iorodeo/i_control_led/README.md

# IO Rodeo i_control_led 

Hardware files for IO Rodeo's current controlled led designed to be used with
our [cuvette holder](https://github.com/iorodeo/cuvette_holder).

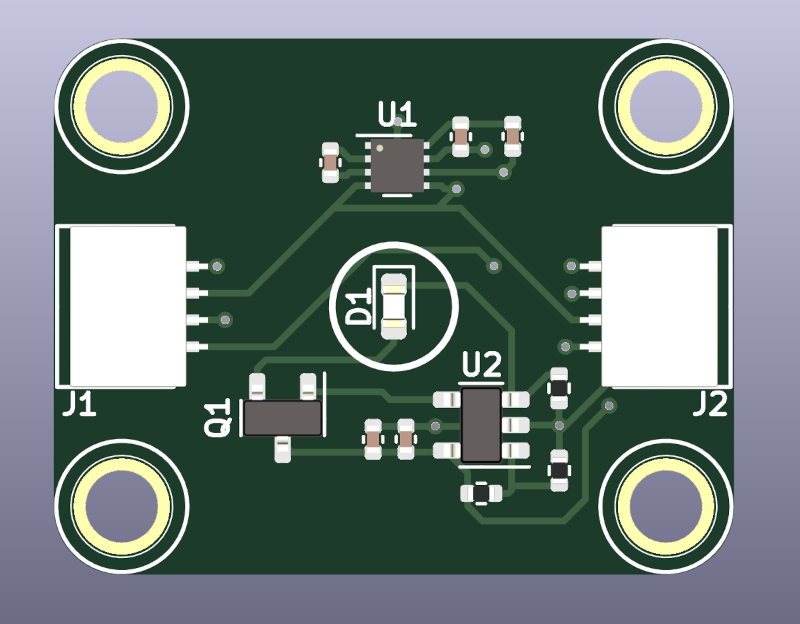
[picture p1: images/i_control_led.png]


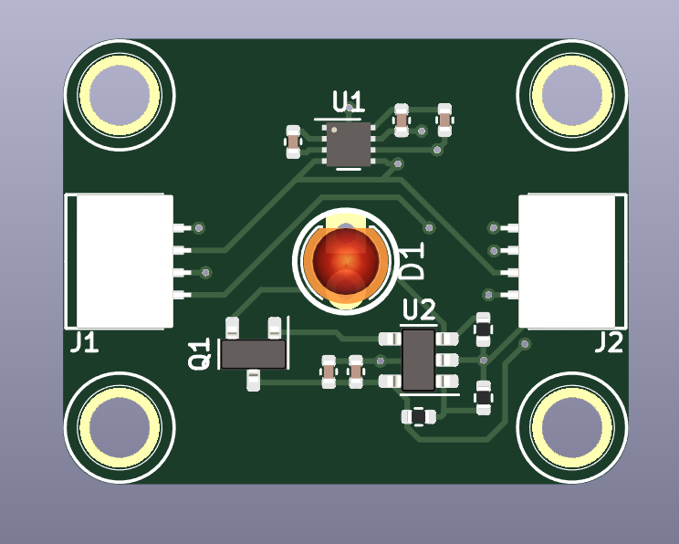
[picture p2: images/i_control_led_radial.png]
