iorodeo/i_control_led/fixed/radial/notes.txt

* Footprints for J1 and J2 (C145956) aren't quite right and had to be corrected
  by JLCPCB. Ask for exact footprint specs ... data sheet doesn't seem to
  specify it completely.
