iorodeo/i_control_led/fixed/10V_regulator/278nm_ELUC3535NUB_16mA/notes.txt

* missing trace between D1 and L1. 

* JLCPCB put LED on wrong way around.

* Footprints for J1 and J2 (C145956) aren't quite right and had to be corrected
  by JLCPCB. Ask for exact footprint specs ... data sheet doesn't seem to
  specify it completely.
