iorodeo/i_control_led/i2c/5V_regulator/SMD0603_i2c/production/ver_0p1_rev_2/BOM_JLCPCB_SMD0603_16mA.xlsx

Comment | Designator | Footprint | LCSC Part #（optional） | Qty
10V 10μF Ceramic Capacitor | C1,C2 C4 | 0402 | C315248 | 3
16V 100nF Ceramic Capacitor | C3 | 0402 | C1525 | 1
4-Pin Connector, JST SM04B-SRSS-TB | J1 ,J2 | SMD,P=1mm | C160404 | 2
4.7μH Inductor ±20%, 440mOhm | L1 | 0603 | C114862 | 1
MMBT5551LT1G Bipolar Transistor, 600mA NPN | Q1 | SOT-23 | C41095 | 1
10Ω ±1% Resistor | R1 | 0402 | C413044 | 1
30kΩ ±1% Resistor | R2 | 0402 | C138008 | 1
1kΩ ±1% Resistor | R3 | 0402 | C144789 | 1
TPS61222DCKR, boost converter, fixed 5V | U1 | SOT-363-6(SC-70-6) | C116461 | 1
LMV321 Operational Amplifier | U2 | SOT-23-5 | C7972 | 1
