iorodeo/i_control_led/fixed/10V_regulator/255nm_IN_C35PPCTGU0_16mA/production/ver_0p1_rev_1/BOM_JLCPCB_255nm_IN_C35PPCTGU0_16mA.xlsx

Comment | Designator | Footprint | LCSC Part #（optional） | Qty
1uF Ceramic Capacitor | C1,C2,C4 | 0402 | C29266 | 3
0.1uF Ceramic Capacitor | C3 | 0402 | C3012376 | 1
255nm UV LED | D1 | 1414 | Global Parts | 1
Schottky Barrier Diode | D2 | SOD-523 | C345957 | 1
4-Pin Connector, JST SM04B-SRSS-TB | J1 ,J2 | SMD,P=1mm | C145956 | 2
22uH Inductor | L1 | 0603 | C383393 | 1
MMBT5551LT1G Bipolar Transistor, 600mA NPN | Q1 | SOT-23 | C41095 | 1
10Ω ±1% Resistor | R1 | 0402 | C25077 | 1
24kΩ ±1% Resistor | R2 | 0402 | C138026 | 1
390Ω ±1% Resistor | R3 | 0402 | C137997 | 1
14kΩ ±1% Resistor | R4,R5 | 0402 | C3015834 | 2
2kΩ ±1% Resistor | R6 | 0402 | C60488 | 1
AP3012KTR-E1 boost converter | U1 | SOT-23-5 | C102618 | 1
AS321 Operational Amplifier | U2 | SOT-23-5 | C144156 | 1
