iorodeo/i_control_led/fixed/10V_regulator/255nm_IN_C35PPCTGU0_16mA/3dmodels/SM04B-SRSS.step

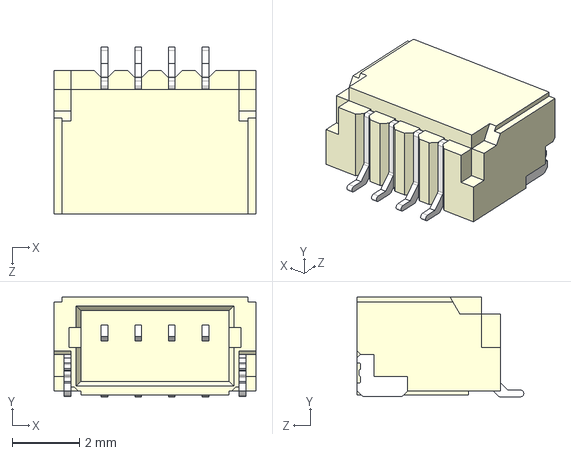
[picture p3: CAD file, 2023-11-25]
fixed/10V_regulator/255nm_IN_C35PPCTGU0_16mA/3dmodels/SM04B-SRSS.step
6.00 x 2.96 x 4.95 mm
