iorodeo/i_control_led/fixed/10V_regulator/255nm_IN_C35PPCTGU0_16mA/schematic_255nm_led_board.pdf

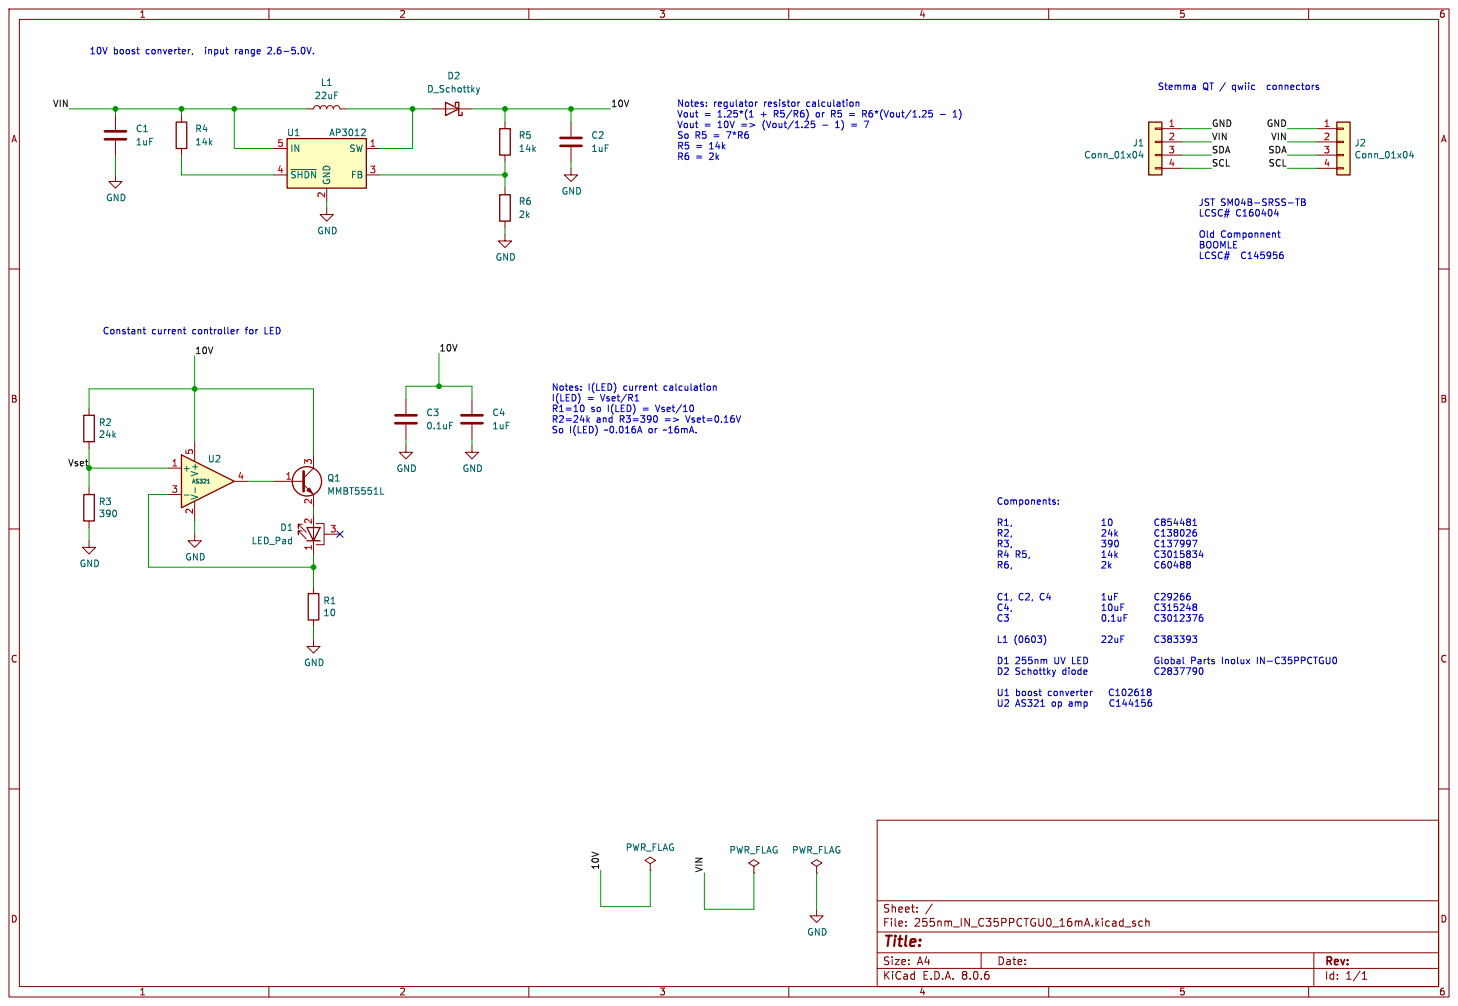
[picture p4: page 1]

JST SM04B-SRSS-TB
LCSC# C160404 Old Componnent BOOMLE

Notes: I(LED) current calculation

Id: 1/1 Title: File: 255nm_IN_C35PPCTGU0_16mA.kicad_sch Sheet: /
