iorodeo/i_control_led/fixed/5V_regulator/850nm_16mA/850nm_16mA.pdf

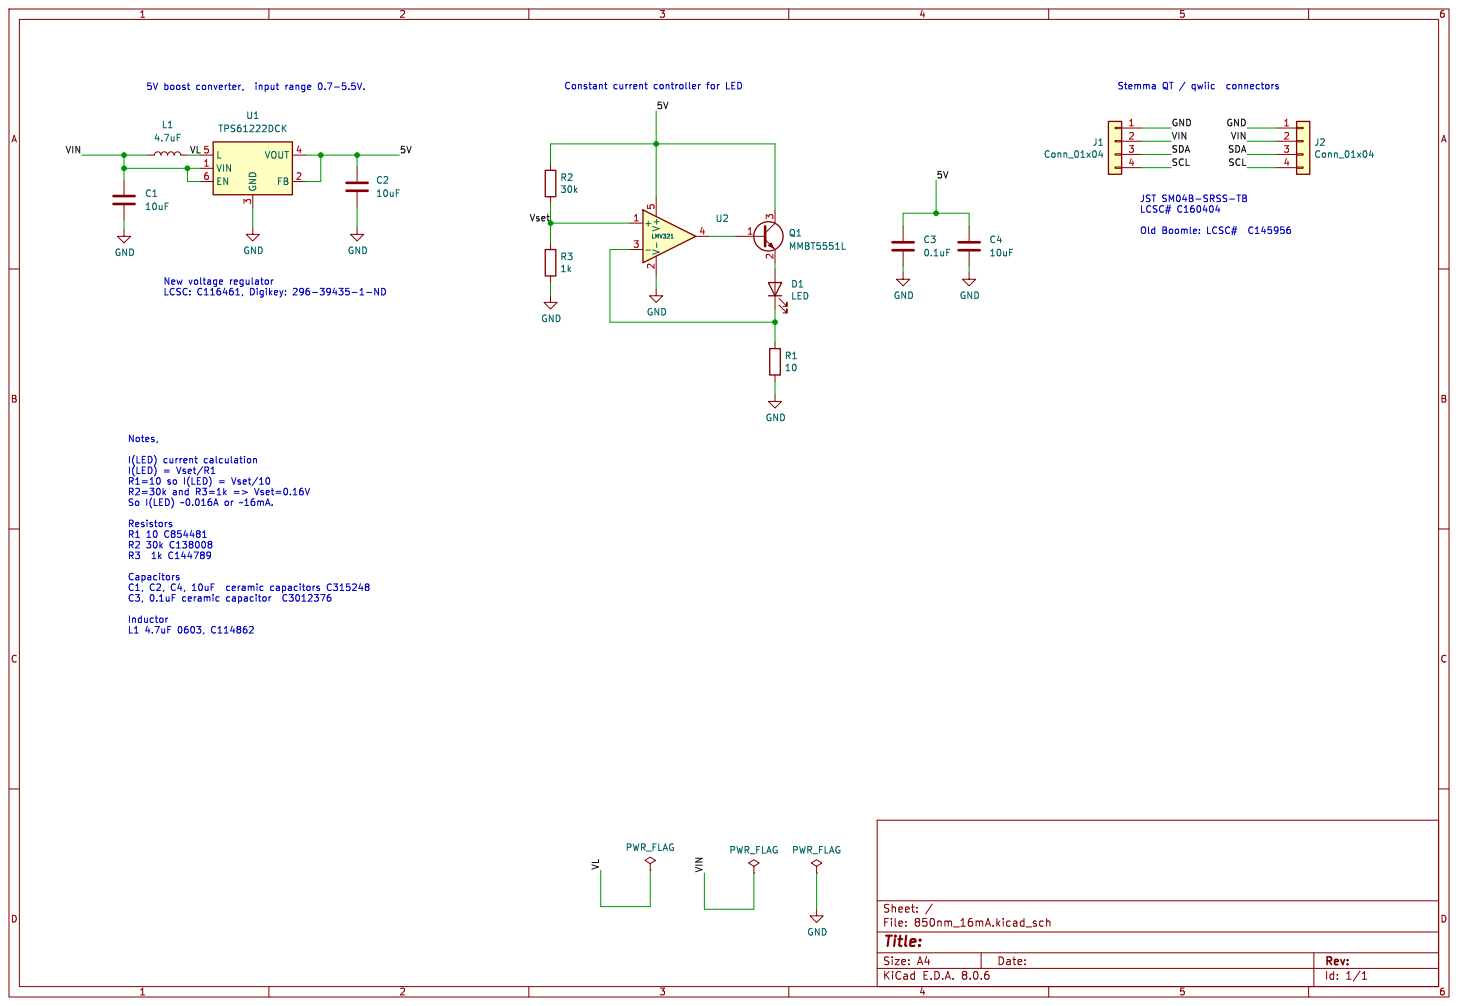
[picture p5: page 1]

Id: 1/1 Title: File: 850nm_16mA.kicad_sch Sheet: /
