iorodeo/i_control_led/fixed/5V_regulator/470nm_16mA/470nm_16mA.pdf

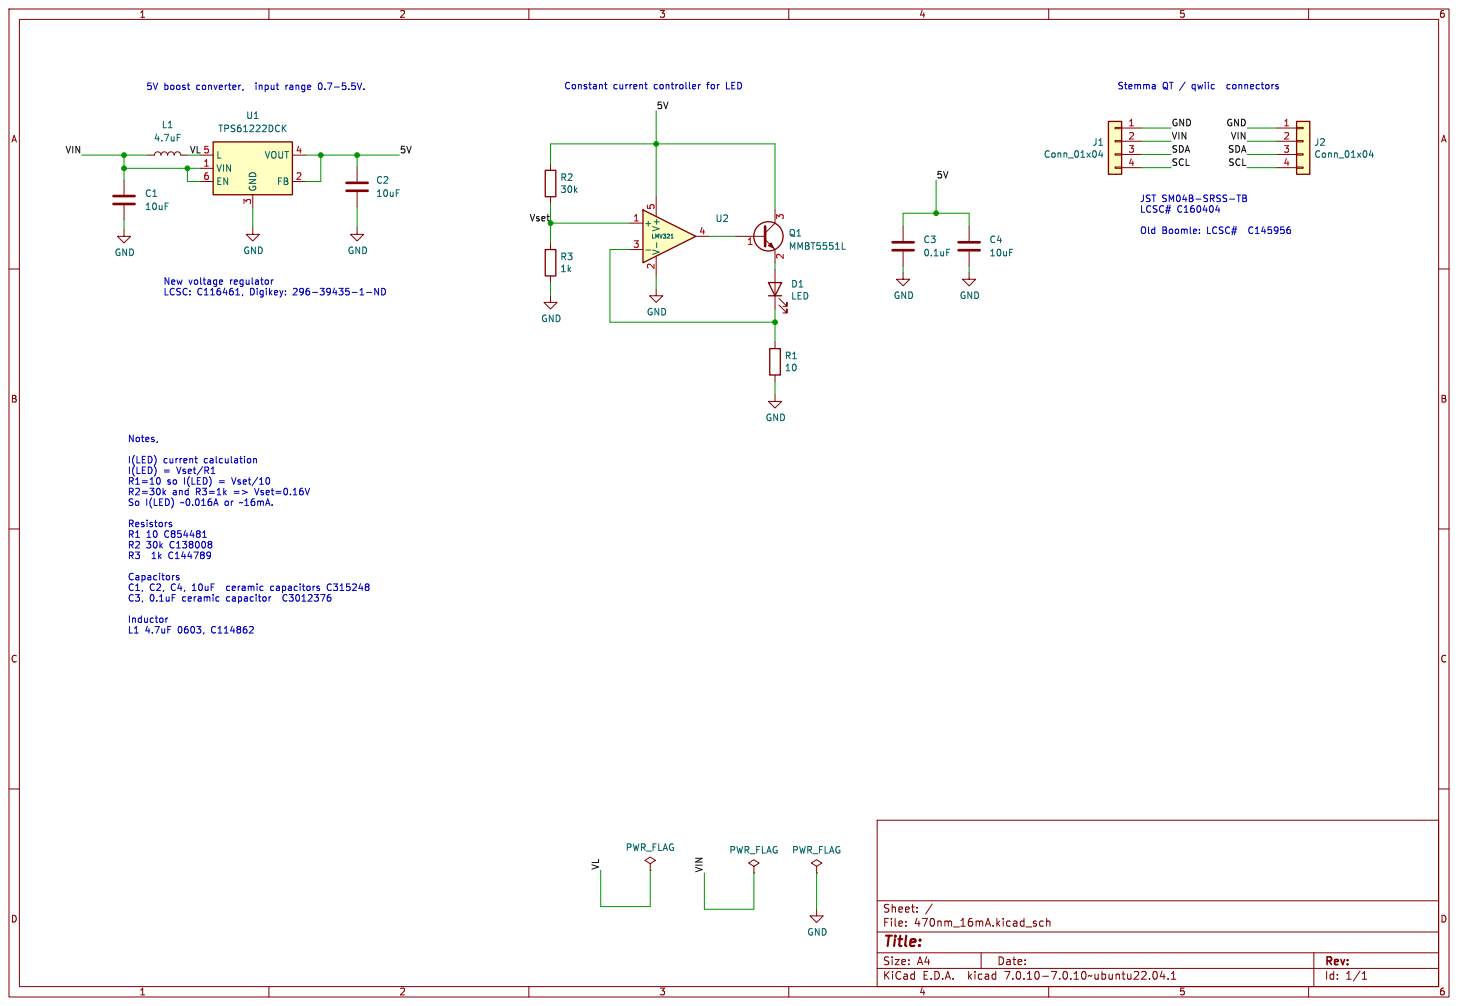
[picture p6: page 1]

Id: 1/1 Title: File: 470nm_16mA.kicad_sch Sheet: /
