iorodeo/i_control_led/(list of files, drawings)

Other design files:
fixed/5V_regulator/365nm_16mA/365nm_16mA.dsn
fixed/5V_regulator/385nm_16mA/385nm_16mA.dsn
fixed/5V_regulator/395nm_16mA/395nm_16mA.dsn
fixed/5V_regulator/415nm_16mA/415nm_16mA.dsn
fixed/5V_regulator/470nm_16mA/470nm_16mA.dsn
fixed/5V_regulator/496nm_16mA/496nm_16mA.dsn
fixed/5V_regulator/520nm_16mA/520nm_16mA.dsn
fixed/5V_regulator/557nm_16mA/557nm_16mA.dsn
fixed/5V_regulator/570nm_16mA/570nm_16mA.dsn
fixed/5V_regulator/595nm_16mA/595nm_16mA.dsn
fixed/5V_regulator/610nm_16mA/610nm_16mA.dsn
fixed/5V_regulator/630nm_16mA/630nm_16mA.dsn
fixed/5V_regulator/660nm_16mA/660nm_16mA.dsn
fixed/5V_regulator/850nm_16mA/850nm_16mA.dsn
fixed/5V_regulator/radial_16mA/radial_16mA.dsn
fixed/5V_regulator/radial_24mA/radial_24mA.dsn
fixed/5V_regulator/SMD0603_16mA/SMD0603_16mA.dsn
fixed/5V_regulator/SMD1212_16mA/SMD1212_16mA.dsn
fixed/5V_regulator/SMD1414_16mA/SMD1414_16mA.dsn
fixed/5V_regulator/white_16mA/white_16mA.dsn
fixed/5V_regulator/white_24mA/white_24mA.dsn
fixed/10V_regulator/255nm_IN_C35PPCTGU0_16mA/255nm_IN_C35PPCTGU0_16mA.dsn
fixed/10V_regulator/275nm_SU_CULBN2/275nm_SU_CULBN2.dsn
fixed/10V_regulator/275nm_SU_CULBN2_16mA/275nm_SU_CULBN2_16mA.dsn
fixed/10V_regulator/275nm_SU_CULBN2_24mA/275nm_SU_CULBN2_24mA.dsn
fixed/10V_regulator/278nm_ELUC3535NUB_16mA/278nm_ELUC3535NUB_16mA.dsn
fixed/10V_regulator/278nm_ELUC3535NUB_24mA/278nm_ELUC3535NUB_24mA.dsn
fixed/10V_regulator/SMD1414_16mA/SMD1414_16mA.dsn
fixed/radial/i_control_led.dsn
fixed/radial_16mA/radial_16mA.dsn
fixed/radial_18mA/i_control_led.dsn
fixed/radial_18mA/radial_18mA.dsn
fixed/radial_24mA/i_control_led.dsn
fixed/radial_24mA/radial_24mA.dsn
fixed/white/i_control_led.dsn
fixed/white_16mA/white_16mA.dsn
fixed/white_18mA/i_control_led.dsn
fixed/white_24mA/white_24mA.dsn
i2c/5V_regulator/SMD0603_i2c/SMD0603_i2c.dsn
