iorodeo/i_control_led/(commit log)

2023-09-15 Project creation.
    [BOM_JLCPCB_white.xlsx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]
2023-09-15 Added fixed current radial led design.
    [BOM_JLCPCB_white.xlsx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]
2023-09-17 Worked on produciton files ... rearranged a directories a bit.
    [CPL_JLCPCB_white.xlsx, i_control_led-B_Cu.gbr, i_control_led-B_Mask.gbr, i_control_led-B_Paste.gbr, i_control_led-B_Silkscreen.gbr, i_control_led-Edge_Cuts.gbr, i_control_led-F_Cu.gbr, i_control_led-F_Mask.gbr]
2023-09-17 Created production files for fixed, led=white, v0p1 rev1.
    [BOM_JLCPCB_white.xlsx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]
2023-09-17 Added 18mA radial design. Finished initial production files.
    [BOM_JLCPCB_radial_18mA.xlsx, BOM_JLCPCB_radial_25mA.xlsx, BOM_JLCPCB_white.xlsx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]
2023-09-17 Fixed part orientations for production.
    [CPL_JLCPCB_radial_18mA.xlsx, CPL_JLCPCB_radial_25mA.xlsx, CPL_JLCPCB_white.xlsx]
2023-09-29 Added spice sims (preliminary).
    [i_control_led.kicad_sch, i_control_sim.kicad_pcb, i_control_sim.kicad_sch, led_sim.kicad_pcb, led_sim.kicad_sch]
2023-09-30 Worked on spice simulations.
    [i_control_sim.kicad_sch, led_sim.kicad_sch]
2023-11-25 Work on rev2 of fixed 25mA radial design.
    Finished layout, routing and fab files.
    [BOM_JLCPCB_radial_25mA.xlsx, SM04B-SRSS.step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]
2023-11-26 Added v0p1 R1 of 18mA fixed.
    [BOM_JLCPCB_radial_16mA.xlsx, BOM_JLCPCB_radial_18mA.xlsx, SM04B-SRSS.step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]
2023-11-26 Renamed 25mA fixed to 24mA.
    [BOM_JLCPCB_radial_24mA.xlsx, BOM_JLCPCB_radial_25mA.xlsx, SM04B-SRSS.step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]
2023-11-26 More rearraning/renaming.
    [BOM_JLCPCB_radial_16mA.xlsx, BOM_JLCPCB_radial_24mA.xlsx, BOM_JLCPCB_radial_25mA.xlsx, SM04B-SRSS.step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]
2023-11-26 Removed fixed/tmp directory.
    [BOM_JLCPCB_radial_24mA.xlsx, BOM_JLCPCB_radial_25mA.xlsx, SM04B-SRSS.step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]
2023-11-26 Added white, fixed, 16mA design.
    [BOM_JLCPCB_white.xlsx, BOM_JLCPCB_white_16mA.xlsx, SM04B-SRSS.step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]
2023-11-26 Remade gerbers for fixed, radial 16mA and 24mA. Simplified traces slighly.
    [radial_16mA-B_Cu.gbl, radial_16mA-B_Mask.gbs, radial_16mA-B_Paste.gbp, radial_16mA-B_Silkscreen.gbo, radial_16mA-Edge_Cuts.gm1, radial_16mA-F_Cu.gtl, radial_16mA-F_Mask.gts, radial_16mA-F_Paste.gtp]
2023-11-26 Added 24mA fixed, white led board.
    [BOM_JLCPCB_white_24mA.xlsx, SM04B-SRSS.step, radial_16mA.kicad_sch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]
2023-11-26 Added 5V_regulator subdirectory to fixed in anticipation of 10V version.
    [BOM_JLCPCB_radial_16mA.xlsx, BOM_JLCPCB_radial_24mA.xlsx, BOM_JLCPCB_radial_25mA.xlsx, BOM_JLCPCB_white_16mA.xlsx, BOM_JLCPCB_white_24mA.xlsx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]
2023-11-26 Updated pcb.
    [white_24mA.kicad_pcb]
2023-11-26 Remade gerbers for fixed, 5V, white, 24mA.
    [white_24mA-B_Cu.gbl, white_24mA-B_Mask.gbs, white_24mA-B_Paste.gbp, white_24mA-B_Silkscreen.gbo, white_24mA-Edge_Cuts.gm1, white_24mA-F_Cu.gtl, white_24mA-F_Mask.gts, white_24mA-F_Paste.gtp]
2023-11-26 Remade gerbers for 5V reg, fixed.
    [radial_16mA-B_Cu.gbl, radial_16mA-B_Mask.gbs, radial_16mA-B_Paste.gbp, radial_16mA-B_Silkscreen.gbo, radial_16mA-Edge_Cuts.gm1, radial_16mA-F_Cu.gtl, radial_16mA-F_Mask.gts, radial_16mA-F_Paste.gtp]
2023-11-27 Worked on 10V, fixed, 24mA 275nm LED
    [275nm_SU_CULBN2-B_Cu.gbl, 275nm_SU_CULBN2-B_Mask.gbs, 275nm_SU_CULBN2-B_Paste.gbp, 275nm_SU_CULBN2-B_Silkscreen.gbo, 275nm_SU_CULBN2-Edge_Cuts.gm1, 275nm_SU_CULBN2-F_Cu.gtl, 275nm_SU_CULBN2-F_Mask.gts, 275nm_SU_CULBN2-F_Paste.gtp]
2023-11-27 Finished component selection for fixed 275nm LED.
    [275nm_SU_CULBN2.kicad_sch]
2023-11-27 Working on 10V, fixed, 275nm LED layout.
    [275nm_SU_CULBN2.kicad_pcb, 275nm_SU_CULBN2.kicad_sch]
2023-11-30 Worked on 10V fixed 257nm LED board.
    [275nm_SU_CULBN2.kicad_pcb]
2023-12-01 Worked on 275nm LED board.
    [275nm_SU_CULBN2.kicad_pcb, 275nm_SU_CULBN2.kicad_sch]
2023-12-03 Added 3D rendering of 275nm LED.
    [275nm_SU_CULBN2.kicad_pcb]
2023-12-04 Added FreeCAD design for 1414 LED.
2023-12-07 Created initial version of fab files for 275nm LED board.
    [275nm_SU_CULBN2-B_Cu.gbl, 275nm_SU_CULBN2-B_Mask.gbs, 275nm_SU_CULBN2-B_Paste.gbp, 275nm_SU_CULBN2-B_Silkscreen.gbo, 275nm_SU_CULBN2-Edge_Cuts.gm1, 275nm_SU_CULBN2-F_Cu.gtl, 275nm_SU_CULBN2-F_Mask.gts, 275nm_SU_CULBN2-F_Paste.gtp]
2023-12-09 Fixed issues with production files.
    [275nm_SU_CULBN2.kicad_sch, BOM_JLCPCB_275nm_SU_CULBN2.xlsx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]
2024-01-25 Added 470nm 16mA fixed version.
    [470nm_16mA-B_Cu.gbl, 470nm_16mA-B_Mask.gbs, 470nm_16mA-B_Paste.gbp, 470nm_16mA-B_Silkscreen.gbo, 470nm_16mA-Edge_Cuts.gm1, 470nm_16mA-F_Cu.gtl, 470nm_16mA-F_Mask.gts, 470nm_16mA-F_Paste.gtp]
2024-01-25 Updated BOM for 16mA fixed 470nm design.
    [BOM_JLCPCB_470nm_16mA.xlsx]
2024-01-26 Changed 470nm LED due for 5V 16mA design due to footprint issue.
    [BOM_JLCPCB_470nm_16mA.xlsx]
2024-01-30 Added fixed 5V, 16mA 365nm design.
    [365nm_16mA-B_Cu.gbl, 365nm_16mA-B_Mask.gbs, 365nm_16mA-B_Paste.gbp, 365nm_16mA-B_Silkscreen.gbo, 365nm_16mA-Edge_Cuts.gm1, 365nm_16mA-F_Cu.gtl, 365nm_16mA-F_Mask.gts, 365nm_16mA-F_Paste.gtp]
2024-01-31 Add fix 5V, 16mA designs for 385, 395, and 415nm LEDs.
    [385nm_16mA-B_Cu.gbl, 385nm_16mA-B_Mask.gbs, 385nm_16mA-B_Paste.gbp, 385nm_16mA-B_Silkscreen.gbo, 385nm_16mA-Edge_Cuts.gm1, 385nm_16mA-F_Cu.gtl, 385nm_16mA-F_Mask.gts, 385nm_16mA-F_Paste.gtp]
2024-02-01 Renamed 10V fixed 275nm SU_CULBN2 so that current is specified.
    [275nm_SU_CULBN2_24mA-B_Cu.gbl, 275nm_SU_CULBN2_24mA-B_Mask.gbs, 275nm_SU_CULBN2_24mA-B_Paste.gbp, 275nm_SU_CULBN2_24mA-B_Silkscreen.gbo, 275nm_SU_CULBN2_24mA-Edge_Cuts.gm1, 275nm_SU_CULBN2_24mA-F_Cu.gtl, 275nm_SU_CULBN2_24mA-F_Mask.gts, 275nm_SU_CULBN2_24mA-F_Paste.gtp]
2024-02-01 Added 10V 24mA 278nm fixed design.
    [278nm_ELUC3535NUB_24mA-B_Cu.gbl, 278nm_ELUC3535NUB_24mA-B_Mask.gbs, 278nm_ELUC3535NUB_24mA-B_Paste.gbp, 278nm_ELUC3535NUB_24mA-B_Silkscreen.gbo, 278nm_ELUC3535NUB_24mA-Edge_Cuts.gm1, 278nm_ELUC3535NUB_24mA-F_Cu.gtl, 278nm_ELUC3535NUB_24mA-F_Mask.gts, 278nm_ELUC3535NUB_24mA-F_Paste.gtp]
2024-02-02 Added fixed 10V, 16mA 275nm and 278nm designs.
    [275nm_SU_CULBN2_16mA-B_Cu.gbl, 275nm_SU_CULBN2_16mA-B_Mask.gbs, 275nm_SU_CULBN2_16mA-B_Paste.gbp, 275nm_SU_CULBN2_16mA-B_Silkscreen.gbo, 275nm_SU_CULBN2_16mA-Edge_Cuts.gm1, 275nm_SU_CULBN2_16mA-F_Cu.gtl, 275nm_SU_CULBN2_16mA-F_Mask.gts, 275nm_SU_CULBN2_16mA-F_Paste.gtp]
2024-02-04 Fixed issue with fixed 10V regulator boards.
    Changed op amp to AS321 to handle higher voltages.
    [275nm_SU_CULBN2_16mA.csv, 275nm_SU_CULBN2_16mA.kicad_pcb, 275nm_SU_CULBN2_16mA.kicad_sch, 275nm_SU_CULBN2_24mA.csv, 275nm_SU_CULBN2_24mA.kicad_pcb, 275nm_SU_CULBN2_24mA.kicad_sch, 278nm_ELUC3535NUB_16mA.csv, 278nm_ELUC3535NUB_16mA.kicad_pcb]
2024-02-04 Added fixed, 5V, 16mA, 595nm design.
    [470nm_16mA-F_Mask.gts, 595nm_16mA-B_Cu.gbl, 595nm_16mA-B_Mask.gbs, 595nm_16mA-B_Paste.gbp, 595nm_16mA-B_Silkscreen.gbo, 595nm_16mA-Edge_Cuts.gm1, 595nm_16mA-F_Cu.gtl, 595nm_16mA-F_Mask.gts]
2024-02-04 Modified led model fit so that led with range.
2024-02-05 Fixed BOM for fixed, 5V, 16mA, 595nm led design.
    [BOM_JLCPCB_595nm_16mA.xlsx]
2024-02-05 Changes for manufacturing.
    Changed diode in 278nm design to SOD-523 due to availability. Changed
    end connected back to BOOMLE due to availability for 365, 385, 395, 415,
    595, and 278nm designs.
    [278nm_ELUC3535NUB_16mA-B_Cu.gbl, 278nm_ELUC3535NUB_16mA-B_Mask.gbs, 278nm_ELUC3535NUB_16mA-B_Paste.gbp, 278nm_ELUC3535NUB_16mA-B_Silkscreen.gbo, 278nm_ELUC3535NUB_16mA-Edge_Cuts.gm1, 278nm_ELUC3535NUB_16mA-F_Cu.gtl, 278nm_ELUC3535NUB_16mA-F_Mask.gts, 278nm_ELUC3535NUB_16mA-F_Paste.gtp]
2024-02-20 Updated silkscreen on 10V, fixed, 16mA 257nm LED board.
    [275nm_SU_CULBN2_16mA-B_Cu.gbl, 275nm_SU_CULBN2_16mA-B_Mask.gbs, 275nm_SU_CULBN2_16mA-B_Paste.gbp, 275nm_SU_CULBN2_16mA-B_Silkscreen.gbo, 275nm_SU_CULBN2_16mA-Edge_Cuts.gm1, 275nm_SU_CULBN2_16mA-F_Cu.gtl, 275nm_SU_CULBN2_16mA-F_Mask.gts, 275nm_SU_CULBN2_16mA-F_Paste.gtp]
2024-02-20 More work on silkscreen changes for fixed, 10V, 16mA 275nm board.
    [275nm_SU_CULBN2_16mA-B_Cu.gbl, 275nm_SU_CULBN2_16mA-B_Mask.gbs, 275nm_SU_CULBN2_16mA-B_Paste.gbp, 275nm_SU_CULBN2_16mA-B_Silkscreen.gbo, 275nm_SU_CULBN2_16mA-Edge_Cuts.gm1, 275nm_SU_CULBN2_16mA-F_Cu.gtl, 275nm_SU_CULBN2_16mA-F_Mask.gts, 275nm_SU_CULBN2_16mA-F_Paste.gtp]
2024-02-20 Modified silkscreen to V0.1 R2 for fixed, 10V, 24mA 275nm.
    [275nm_SU_CULBN2_16mA-B_Cu.gbl, 275nm_SU_CULBN2_16mA-B_Mask.gbs, 275nm_SU_CULBN2_16mA-B_Paste.gbp, 275nm_SU_CULBN2_16mA-B_Silkscreen.gbo, 275nm_SU_CULBN2_16mA-Edge_Cuts.gm1, 275nm_SU_CULBN2_16mA-F_Cu.gtl, 275nm_SU_CULBN2_16mA-F_Mask.gts, 275nm_SU_CULBN2_16mA-F_Paste.gtp]
2024-02-20 Change diode in fixed 10V, 16mA, 275nm design.
    [275nm_SU_CULBN2_16mA-B_Cu.gbl, 275nm_SU_CULBN2_16mA-B_Mask.gbs, 275nm_SU_CULBN2_16mA-B_Paste.gbp, 275nm_SU_CULBN2_16mA-B_Silkscreen.gbo, 275nm_SU_CULBN2_16mA-Edge_Cuts.gm1, 275nm_SU_CULBN2_16mA-F_Cu.gtl, 275nm_SU_CULBN2_16mA-F_Mask.gts, 275nm_SU_CULBN2_16mA-F_Paste.gtp]
2024-02-20 Change schottky diode on fixed,10V,24mA,275nm design.
    [275nm_SU_CULBN2_24mA-B_Cu.gbl, 275nm_SU_CULBN2_24mA-B_Mask.gbs, 275nm_SU_CULBN2_24mA-B_Paste.gbp, 275nm_SU_CULBN2_24mA-B_Silkscreen.gbo, 275nm_SU_CULBN2_24mA-Edge_Cuts.gm1, 275nm_SU_CULBN2_24mA-F_Cu.gtl, 275nm_SU_CULBN2_24mA-F_Mask.gts, 275nm_SU_CULBN2_24mA-F_Paste.gtp]
2024-02-20 Minor modifications to 10V, fixed, 257nm designs.
    Swap 10 Ohm 1% resistor to an equivalent part with better availability.
    [BOM_JLCPCB_275nm_SU_CULBN2_16mA.xlsx, BOM_JLCPCB_275nm_SU_CULBN2_24mA.xlsx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]
2024-03-16 Added fixed, 5V, 16mA, 557nm led design.
    [557nm_16mA-B_Cu.gbl, 557nm_16mA-B_Mask.gbs, 557nm_16mA-B_Paste.gbp, 557nm_16mA-B_Silkscreen.gbo, 557nm_16mA-Edge_Cuts.gm1, 557nm_16mA-F_Cu.gtl, 557nm_16mA-F_Mask.gts, 557nm_16mA-F_Paste.gtp]
2024-03-16 Added fixed 5V, 16mA, 496nm design.
    [496nm_16mA-B_Cu.gbl, 496nm_16mA-B_Mask.gbs, 496nm_16mA-B_Paste.gbp, 496nm_16mA-B_Silkscreen.gbo, 496nm_16mA-Edge_Cuts.gm1, 496nm_16mA-F_Cu.gtl, 496nm_16mA-F_Mask.gts, 496nm_16mA-F_Paste.gtp]
2024-03-16 Added fixed, 5V, 16mA, 570nm design.
    [570nm_16mA-B_Cu.gbl, 570nm_16mA-B_Mask.gbs, 570nm_16mA-B_Paste.gbp, 570nm_16mA-B_Silkscreen.gbo, 570nm_16mA-Edge_Cuts.gm1, 570nm_16mA-F_Cu.gtl, 570nm_16mA-F_Mask.gts, 570nm_16mA-F_Paste.gtp]
2024-03-16 Added fixed 5V, 16mA, 660nm design.
    [660nm_16mA-B_Cu.gbl, 660nm_16mA-B_Mask.gbs, 660nm_16mA-B_Paste.gbp, 660nm_16mA-B_Silkscreen.gbo, 660nm_16mA-Edge_Cuts.gm1, 660nm_16mA-F_Cu.gtl, 660nm_16mA-F_Mask.gts, 660nm_16mA-F_Paste.gtp]
2024-03-16 Added fixed, 5V, 16mA, 520nm design.
    [520nm_16mA-B_Cu.gbl, 520nm_16mA-B_Mask.gbs, 520nm_16mA-B_Paste.gbp, 520nm_16mA-B_Silkscreen.gbo, 520nm_16mA-Edge_Cuts.gm1, 520nm_16mA-F_Cu.gtl, 520nm_16mA-F_Mask.gts, 520nm_16mA-F_Paste.gtp]
2024-03-16 Added fixed, 5V, 16mA, 850nm design.
    [850nm_16mA-B_Cu.gbl, 850nm_16mA-B_Mask.gbs, 850nm_16mA-B_Paste.gbp, 850nm_16mA-B_Silkscreen.gbo, 850nm_16mA-Edge_Cuts.gm1, 850nm_16mA-F_Cu.gtl, 850nm_16mA-F_Mask.gts, 850nm_16mA-F_Paste.gtp]
2024-04-15 Added 5V fixed 610nm design.
    [610nm_16mA-B_Cu.gbl, 610nm_16mA-B_Mask.gbs, 610nm_16mA-B_Paste.gbp, 610nm_16mA-B_Silkscreen.gbo, 610nm_16mA-Edge_Cuts.gm1, 610nm_16mA-F_Cu.gtl, 610nm_16mA-F_Mask.gts, 610nm_16mA-F_Paste.gtp]
2024-04-15 Added 5V fixed 630nm design.
    [630nm_16mA-B_Cu.gbl, 630nm_16mA-B_Mask.gbs, 630nm_16mA-B_Paste.gbp, 630nm_16mA-B_Silkscreen.gbo, 630nm_16mA-Edge_Cuts.gm1, 630nm_16mA-F_Cu.gtl, 630nm_16mA-F_Mask.gts, 630nm_16mA-F_Paste.gtp]
2024-04-15 Changed LED part # for fixed 5V 630nm design.
    [BOM_JLCPCB_630nm_16mA.xlsx]
2024-04-16 Change part # for 630nm led design.
    [BOM_JLCPCB_630nm_16mA.xlsx]
2024-05-08 Added alternate part for end connector to 595nm design.
    [595nm_16mA.kicad_sch, BOM_JLCPCB_595nm_16mA_alt.xlsx]
2024-06-21 Fixed missing trace issue on rev 1 of 278nm 16mA PCB.
    [278nm_ELUC3535NUB_16mA-B_Cu.gbl, 278nm_ELUC3535NUB_16mA-B_Mask.gbs, 278nm_ELUC3535NUB_16mA-B_Paste.gbp, 278nm_ELUC3535NUB_16mA-B_Silkscreen.gbo, 278nm_ELUC3535NUB_16mA-Edge_Cuts.gm1, 278nm_ELUC3535NUB_16mA-F_Cu.gtl, 278nm_ELUC3535NUB_16mA-F_Mask.gts, 278nm_ELUC3535NUB_16mA-F_Paste.gtp]
2024-06-21 Added fixed 10V 16mA design for 255nm LED.
    [255nm_IN_C35PPCTGU0_16mA-B_Cu.gbl, 255nm_IN_C35PPCTGU0_16mA-B_Mask.gbs, 255nm_IN_C35PPCTGU0_16mA-B_Paste.gbp, 255nm_IN_C35PPCTGU0_16mA-B_Silkscreen.gbo, 255nm_IN_C35PPCTGU0_16mA-Edge_Cuts.gm1, 255nm_IN_C35PPCTGU0_16mA-F_Cu.gtl, 255nm_IN_C35PPCTGU0_16mA-F_Mask.gts, 255nm_IN_C35PPCTGU0_16mA-F_Paste.gtp]
2024-10-01 Modified silkscreens on fixed, 5V radial designs.
    Added white user writable silkscreen area to both fixed, 5V, radial
    designs.
    [BOM_JLCPCB_radial_16mA.xlsx, BOM_JLCPCB_radial_24mA.xlsx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]
2024-10-01 Updated BOM's for 5V fixed radial boards.
    There was no stock for 100nF 0402 capacitor. Replaced with a equivalent
    one.
    [BOM_JLCPCB_radial_16mA.xlsx, BOM_JLCPCB_radial_24mA.xlsx]
2024-11-19 Added part alternates for 595nm.
2024-12-28 Modified BOM and CPLs of 470, 420, 557, 570, 660, 850 nm LEDs for new orders.
    [BOM_JLCPCB_470nm_16mA.xlsx, BOM_JLCPCB_520nm_16mA.xlsx, BOM_JLCPCB_557nm_16mA.xlsx, BOM_JLCPCB_570nm_16mA.xlsx, BOM_JLCPCB_660nm_16mA.xlsx, BOM_JLCPCB_850nm_16mA.xlsx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]
2025-09-19 Added generic 16mA SMD0603 5V fixed led board.
    [BOM_JLCPCB_SMD0603_16mA.xlsx, SM04B-SRSS.step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]
2025-09-19 Adjusted silkscreen on 5V fixed generic SMD0603 led board
    [SMD0603_16mA-B_Cu.gbl, SMD0603_16mA-B_Mask.gbs, SMD0603_16mA-B_Paste.gbp, SMD0603_16mA-B_Silkscreen.gbo, SMD0603_16mA-Edge_Cuts.gm1, SMD0603_16mA-F_Cu.gtl, SMD0603_16mA-F_Mask.gts, SMD0603_16mA-F_Paste.gtp]
2026-02-20 AddedSMD1414 fixed variant with unpopulated led.
    [BOM_JLCPCB_SMD1414_16mA.xlsx, SM04B-SRSS.step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]
2026-04-23 Worked on SM1212 16mA 5V led.
    [BOM_JLCPCB_SMD0603_16mA.xlsx, SM04B-SRSS.step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]
2026-04-24 Added part # to 'Symbol Fields Table" for SMD1212_16mA design.
    [SMD1212_16mA.kicad_pcb, SMD1212_16mA.kicad_sch]
2026-04-24 Worked on creating production files using Fab Toolkit.
    Still need to fix so part rotations.
    [BOM_JLCPCB_SMD0603_16mA.xlsx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]
2026-04-29 Fixed rotation issues.
    [BOM_JLCPCB_SMD0603_16mA.xlsx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]
2026-05-01 Added new 5V fixed SMD1414 design.
    [SM04B-SRSS.step, SMD1414_16mA.csv, SMD1414_16mA.dsn, SMD1414_16mA.kicad_pcb, SMD1414_16mA.kicad_sch, bom.csv, designators.csv, positions.csv]
2026-05-01 Remnade production files for 5V 1212 and 1414 designs.
2026-06-26 Worked on i2c controlled LED.
    [BOM_JLCPCB_SMD0603_16mA.xlsx, SM04B-SRSS.step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]
2026-07-07 Worked on I2C current controlled LED board.
    [SMD0603_i2c.kicad_pcb, SMD0603_i2c.kicad_sch]
2026-07-08 Worked on layout and routing for 5V i2c controlled design.
    [SMD0603_i2c.kicad_pcb, SMD0603_i2c.kicad_sch]
